lyyi211/acoustic-levitator/hardware/README.uk.md

# Електроніка

Для двох синхронних каналів було вибрано Arduino Uno, подвійний міст TB6612FNG та інвертор 74HC14. У схемі прийнято живлення логіки 5 В і живлення моста 9 В з обмеженням струму 1 А. Кожен канал живить 36 паралельно з’єднаних передавачів через неіндуктивний резистор 22 Ом, 3 Вт.

| Сигнал | З’єднання |
|---|---|
| D9 / D10 | AIN1 / BIN1 і два входи інвертора |
| Виходи інвертора | AIN2 / BIN2 |
| D8 | STBY із резистором 100 кОм до землі |
| PWMA, PWMB, VCC | 5 В |
| AO1 / AO2 | Верхній масив через R2 |
| BO1 / BO2 | Нижній масив через R3 |
| VM | Живлення 9 В через запобіжник |
| GND | Спільна земля |

У схемі є три блокувальні конденсатори по 100 нФ і накопичувальний конденсатор 470 мкФ. 

Плата HC-SR04 містить передавач, приймач та електроніку імпульсного вимірювання відстані. У масив входять лише передавальні капсулі. Живлення модуля 5 В не визначає допустимої напруги безперервного збудження випаяного передавача.

Для електричного розрахунку було задано ємність одного передавача 2 нФ. 

```math
C_{\mathrm{bank}}=36C_T=72\ \mathrm{nF},\qquad V_{\mathrm{bridge,pp}}=2V_M=18\ \mathrm{V}.
```

Номінальна ідеалізована схема дає 17,983 В від піка до піка на масиві, 201,6 мА середньоквадратичного струму, 775,4 мА пікового струму та 0,895 Вт на резисторі кожного масиву. Дослідження чутливості охоплює 5, 7 і 9 В та множники ємності 0,8, 1,0 і 1,2. 

`Reference` у BOM — позиційне позначення компонента на схемі, а не посилання на джерело чи постачальника. `U1` позначає Arduino Uno, `U2` і `U3` — міст та інвертор, `TX1–TX72` — випромінювачі. `R`, `C`, `F`, `J`, `PS` і `MECH` позначають резистори, конденсатори, запобіжник, роз’єми, джерело живлення та механічні деталі. Quantity — кількість фізичних деталей у рядку.
