lyyi211/acoustic-levitator/tools/README.md

# Software used

OpenSCAD was used for the parametric mechanical structure, Python with NumPy and Matplotlib for acoustic calculations and figures, ngspice for the electrical load model, and Arduino IDE / Arduino CLI for the Uno firmware.
