lyyi211/acoustic-levitator/tools/README.uk.md

# Використане програмне забезпечення

Для параметричної механічної конструкції було використано OpenSCAD, для акустичних розрахунків і графіків — Python із NumPy та Matplotlib, для моделі електричного навантаження — ngspice, для прошивки Uno — Arduino IDE / Arduino CLI.
