lyyi211/acoustic-levitator/hardware/netlist.csv

Net | Pin 1 | Pin 2 | Additional connections | Notes
+5V | U1.5V | U2.VCC | U3.VCC; U2.PWMA; U2.PWMB | Regulated logic supply; local 100 nF decoupling
GND | U1.GND | U2.GND | U3.GND; C4-; power return | Star connection near power input
VM_FUSED | J1.POS | F1.1 |  | 9 V DC input; 1 A current limit
VM | F1.2 | U2.VM | C4+ | Short high-current loop
BANK_A_PWM | U1.D9_OC1A | U2.AIN1 | U3.1A | Hardware Timer1 output
BANK_A_N | U3.1Y | U2.AIN2 |  | Complementary bridge input
BANK_B_PWM | U1.D10_OC1B | U2.BIN1 | U3.2A | Hardware Timer1 output
BANK_B_N | U3.2Y | U2.BIN2 |  | Complementary bridge input
BRIDGE_ENABLE | U1.D8 | U2.STBY | R1.1 | R1.2 connects to GND
BANK_A_P | U2.AO1 | R2.1 |  | 22 Ohm >=3 W series damping
BANK_A_LOAD | R2.2 | J2.1 | TX1-TX36.POS | Upper concave bank; 36 parallel emitters
BANK_A_M | U2.AO2 | J2.2 |  | Upper bank differential terminal
BANK_B_P | U2.BO1 | R3.1 |  | 22 Ohm >=3 W series damping
BANK_B_LOAD | R3.2 | J3.1 | TX37-TX72.POS | Lower concave bank; 36 parallel emitters
BANK_B_M | U2.BO2 | J3.2 |  | Lower bank differential terminal
