lyyi211/acoustic-levitator/mechanical/README.uk.md

# Механічна модель

В OpenSCAD було спроєктовано дві однакові увігнуті чаші та спільну опорну раму. У кожній чаші 36 радіальних гнізд у трьох шестикутних кільцях по 6, 12 і 18 елементів. Для конструкції вибрано передавальні капсулі, випаяні з HC-SR04, а не цілі плати далекомірів чи приймальні капсулі.

| Параметр | Значення в CAD |
|---|---:|
| Діаметр / висота корпусу випромінювача | 16 / 13 мм |
| Діаметр гнізда / глибина посадки | 16,4 / 13 мм |
| Крок між центрами в проєкції | 18 мм |
| Радіус спільного фокуса | 90 мм |
| Зовнішній діаметр чаші / товщина оболонки | 142 / 15 мм |
| Задній отвір для виводів / центральний отвір | 6 / 8 мм |
| Розміри основи | 220 × 158 мм |
| Кріплення | Чотири болти M4 × 20 мм, чотири гайки, вісім шайб |

Розміри корпусів отримано з приблизних вимірів наявних деталей. Гніздо має діаметральний зазор 0,4 мм і задній посадковий уступ. Чаші спрямовані всередину; кожне монтажне вушко спирається на полицю рами. Основа, стійки й полиці утворюють суцільну деталь.

Центри робочих поверхонь лежать на сфері навколо спільного фокуса. Уявні полюси розділяє 180 мм; у самих полюсах випромінювачів немає. Відстань між найближчими протилежними центрами робочих поверхонь — 144 мм. Це геометричні відстані, а не задана умова резонансу порожнини.

CAD містить окремі моделі чаші та рами, вигляд збірки й зразок гнізда. `design.json` задає спільні розміри для CAD та акустичної моделі. Аналіз сітки описує зв’язність, замкненість поверхні, орієнтацію граней і топологію отворів.
