lyyi211/acoustic-levitator/simulation/README.uk.md

# Чисельна модель

Усі 72 джерела було змодельовано як орієнтовані поршневі випромінювачі в екрані та розраховано тиск, потенціал Горькова, радіаційну силу й локальну жорсткість у трьох вимірах. Геометрія використовує ті самі параметри, що й конструкція OpenSCAD. Прийнятий активний радіус поршня — 6 мм, зовнішній радіус корпусу — 8 мм.

Опорний піковий тиск у синфазному фокусі становить 1,5 кПа. Він один раз задає амплітуду джерел; порівняння фаз, частот і геометрії зберігають цю амплітуду. Вона не розраховується з напруги моста 9 В. Частинка в моделі — сфера радіусом 0,30 мм, густиною 30 кг/м³ і стисливістю 2,5 × 10⁻¹⁰ Па⁻¹.

Вертикальний пошук охоплює ділянку від −62 до +62 мм. Він знаходить 18 осьово стійких рівноваг, із яких 15 також мають додатну жорсткість у всіх трьох напрямках. Це положення окремої частинки. Одночасне заповнення та розсіювання між частинками не моделюються. Маса однієї частинки — 3,393 мкг; заповнення всіх 15 положень дало б сумарно 50,894 мкг у наближенні незалежних частинок.

Пошук використовує сітку 0,10 мм, поділ інтервалів зі зміною знака сили навпіл і скінченні різниці з кроком 20 мкм. Другий розрахунок із сіткою 0,05 мм та різницями 10 мкм оцінює чутливість результату. Модель поля не враховує відбиття, термов’язкі ефекти, акустичні течії, відмінності джерел і нелінійне поширення. Повне виведення, графіки та пояснення зібрано в розділі фізики, доступному безпосередньо з головного README.
