lyyi211/acoustic-levitator/results/socket_fit_coupon.stl

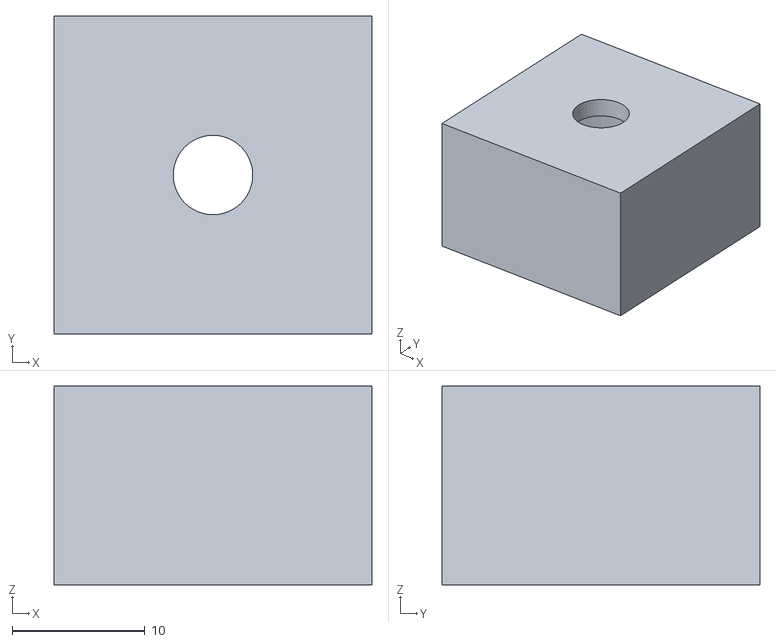
[picture p9: CAD file, 2026-10-31]
results/socket_fit_coupon.stl
24.0 x 24.0 x 15.0
