lyyi211/acoustic-levitator/results/concave_cup.stl

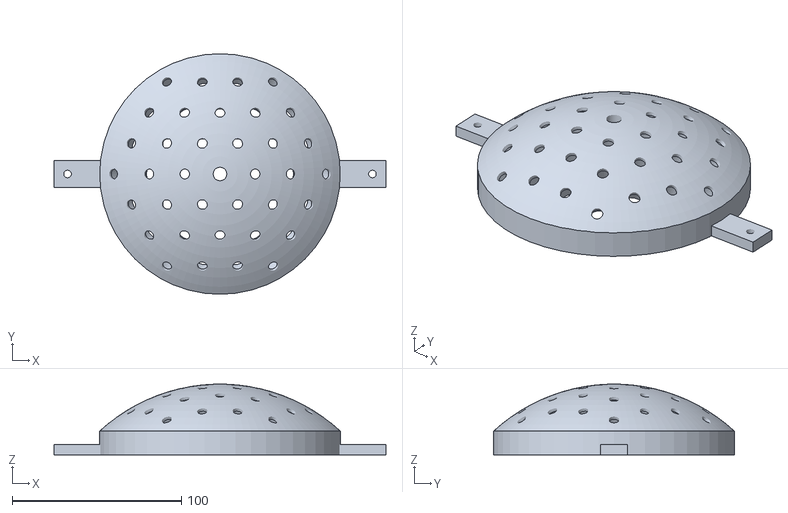
[picture p10: CAD file, 2026-10-31]
results/concave_cup.stl
196.0 x 142.0 x 41.6
