lyyi211/acoustic-levitator/results/levitator_frame.stl

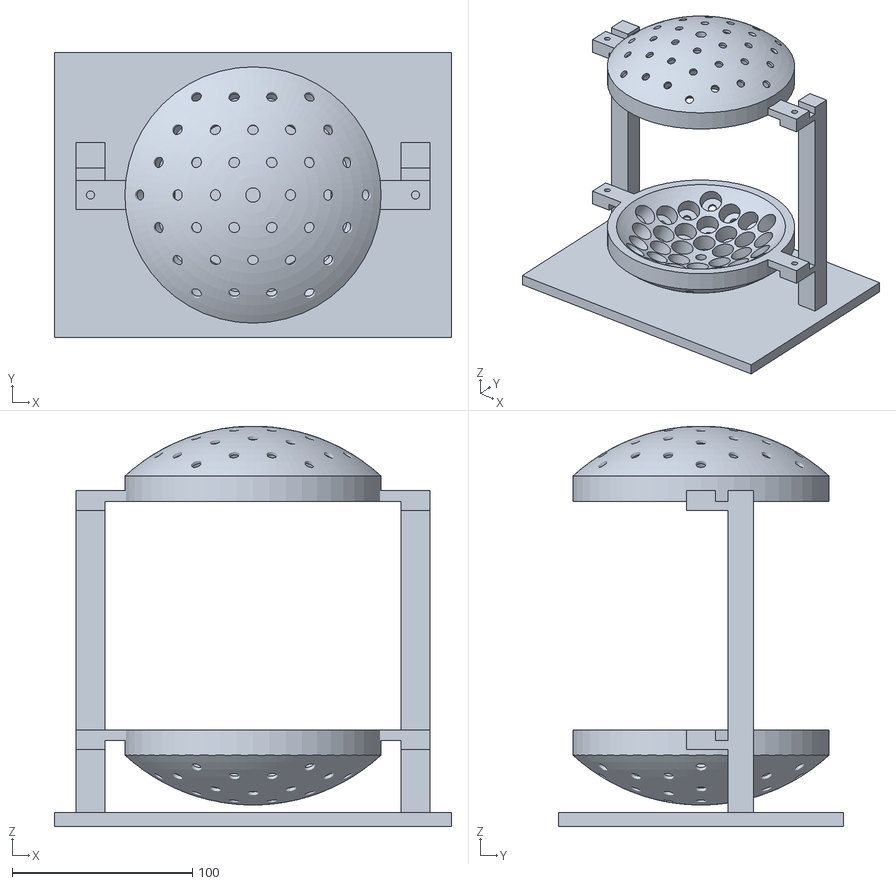
[picture p11: CAD file, 2026-10-31]
results/levitator_frame.stl
220.0 x 158.0 x 221.9
