lyyi211/acoustic-levitator/results/support_frame.stl

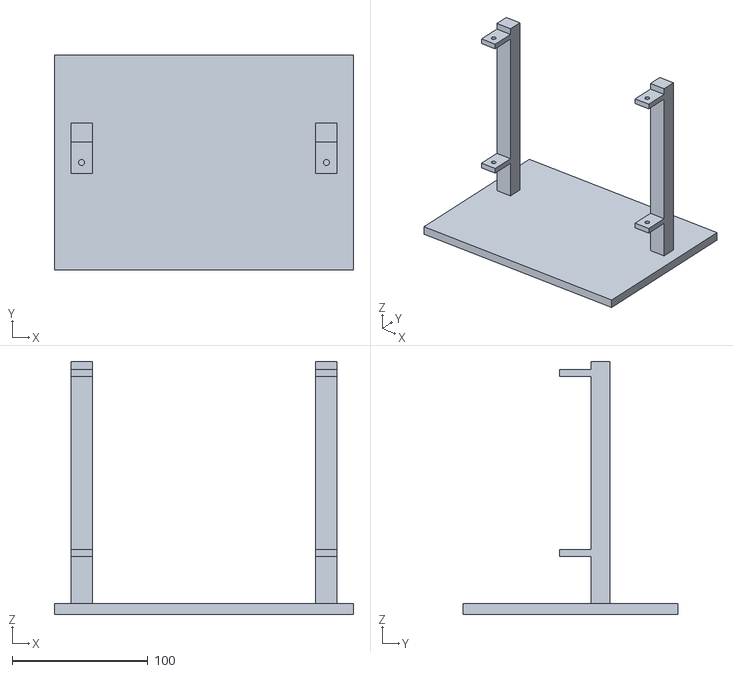
[picture p12: CAD file, 2026-10-31]
results/support_frame.stl
220.0 x 158.0 x 186.3
