lyyi211/acoustic-levitator/mechanical/generated_geometry.scad

// Generated by simulation/array_geometry.py; edit design.json instead.
curvature_radius_mm = 90;
hex_pitch_mm = 18;
hex_rings = 3;
transducer_diameter_mm = 16;
socket_clearance_mm = 0.4;
transducer_body_height_mm = 13;
shell_thickness_mm = 15;
rear_wire_clearance_mm = 6;
cap_inner_aperture_radius_mm = 64;
cup_outer_radius_mm = 71;
center_access_diameter_mm = 8;
ear_thickness_mm = 6;
ear_half_width_mm = 8;
mount_x_mm = 90;
bolt_clearance_mm = 4.5;
post_depth_mm = 14;
post_y_mm = 22;
shelf_thickness_mm = 5;
base_width_mm = 220;
base_depth_mm = 158;
base_thickness_mm = 8;
base_clearance_mm = 4;
frequency_hz = 40000;
emitter_capacitance_pf = 2000;
bridge_supply_v = 9;
series_resistance_ohm = 22;
assumed_piston_radius_mm = 6;
assumed_focus_peak_pa = 1500;
pressure_reference_distance_mm = 100;
rim_z_mm = 63.2771680782;
base_top_mm = -109;
base_bottom_mm = -117;
lower_seat_z_mm = -69.2771680782;
upper_seat_z_mm = 63.2771680782;
upper_face_centres_mm = [
  [-54, 0, 72],
  [-45, 15.5884572681, 76.3675323681],
  [-36, 31.1769145362, 76.3675323681],
  [-27, 46.7653718044, 72],
  [-45, -15.5884572681, 76.3675323681],
  [-36, 0, 82.4863625092],
  [-27, 15.5884572681, 84.4274836768],
  [-18, 31.1769145362, 82.4863625092],
  [-9, 46.7653718044, 76.3675323681],
  [-36, -31.1769145362, 76.3675323681],
  [-27, -15.5884572681, 84.4274836768],
  [-18, 0, 88.1816307402],
  [-9, 15.5884572681, 88.1816307402],
  [0, 31.1769145362, 84.4274836768],
  [9, 46.7653718044, 76.3675323681],
  [-27, -46.7653718044, 72],
  [-18, -31.1769145362, 82.4863625092],
  [-9, -15.5884572681, 88.1816307402],
  [9, 15.5884572681, 88.1816307402],
  [18, 31.1769145362, 82.4863625092],
  [27, 46.7653718044, 72],
  [-9, -46.7653718044, 76.3675323681],
  [0, -31.1769145362, 84.4274836768],
  [9, -15.5884572681, 88.1816307402],
  [18, 0, 88.1816307402],
  [27, 15.5884572681, 84.4274836768],
  [36, 31.1769145362, 76.3675323681],
  [9, -46.7653718044, 76.3675323681],
  [18, -31.1769145362, 82.4863625092],
  [27, -15.5884572681, 84.4274836768],
  [36, 0, 82.4863625092],
  [45, 15.5884572681, 76.3675323681],
  [27, -46.7653718044, 72],
  [36, -31.1769145362, 76.3675323681],
  [45, -15.5884572681, 76.3675323681],
  [54, 0, 72],
];
