lyyi211/acoustic-levitator/results/view_export.scad

// View the exported mesh alongside the editable mechanical source.
import("levitator_frame.stl");
