lyyi211/acoustic-levitator/results/README.uk.md

# Результати розрахунків

У цій папці зібрано механічні моделі, акустичні графіки та чисельні таблиці для випромінювачів 16 × 13 мм. Розділ фізики містить зображення з поясненнями; прямі посилання на всі групи файлів зібрано в головному README.

Механічні файли описують дві чаші, спільну раму, збірку та зразок гнізда. `mesh_validation.json` містить властивості сіток. `array_geometry.csv` задає центри й нормалі 72 робочих поверхонь, а `model_summary.csv` — рівноваги на 38, 40 і 42 кГц. `axial_traps.csv` містить кожну осьово стійку рівновагу в дослідженому інтервалі та три власні значення її жорсткості. `capacity_summary.json` зберігає масу частинки, кількість положень і межі застосування моделі.

`simulation_metadata.json` містить припущення. `driver_waveforms.csv` — таблиця з пробільними роздільниками: час, напруга моста, напруга масиву, струм і потужність резистора. `driver_sweep.csv` містить дев’ять сценаріїв електричної чутливості.
