lyyi211/acoustic-levitator/results/array_geometry.csv

bank | element | x_mm | y_mm | z_mm | nx | ny | nz
upper | 1 | -54.00000000000001 | 0.0 | 72.0 | 0.6000000000000001 | -0.0 | -0.7999999999999999
upper | 2 | -45.00000000000001 | 15.588457268119896 | 76.36753236814712 | 0.5000000000000001 | -0.17320508075688773 | -0.848528137423857
upper | 3 | -36.00000000000001 | 31.176914536239792 | 76.36753236814712 | 0.4000000000000001 | -0.34641016151377546 | -0.848528137423857
upper | 4 | -27.000000000000004 | 46.76537180435969 | 72.0 | 0.30000000000000004 | -0.5196152422706632 | -0.7999999999999999
upper | 5 | -45.00000000000001 | -15.588457268119896 | 76.36753236814712 | 0.5000000000000001 | 0.17320508075688773 | -0.848528137423857
upper | 6 | -36.00000000000001 | 0.0 | 82.48636250920512 | 0.4000000000000001 | -0.0 | -0.916515138991168
upper | 7 | -27.000000000000004 | 15.588457268119896 | 84.42748367682172 | 0.30000000000000004 | -0.17320508075688773 | -0.9380831519646858
upper | 8 | -18.000000000000004 | 31.176914536239792 | 82.48636250920512 | 0.20000000000000004 | -0.34641016151377546 | -0.916515138991168
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
