lyyi211/acoustic-levitator/results/axial_traps.csv

z_m | K1_N_per_m | K2_N_per_m | K3_N_per_m | stable_3d | residual_force_N
-0.039677996788918965 | 3.8109598494231963e-06 | 3.8109598573315545e-06 | 5.444547475140875e-05 | True | 3.5015670203156874e-17
-0.03470935393720864 | 3.170006207659804e-06 | 3.1700062086731356e-06 | 7.493835035776227e-05 | True | 1.4981106915038845e-17
-0.030440448923408983 | -5.786958120129833e-06 | -5.786958112732257e-06 | 4.3627215809627975e-05 | False | 2.6112405335736926e-17
-0.02664662252813577 | 8.746844813905172e-07 | 8.74684507700526e-07 | 4.613671963533076e-05 | True | 3.498668945138881e-18
-0.02175730469077825 | 1.1423531913955067e-05 | 1.1423531954701224e-05 | 0.0002049696468058302 | True | 2.337198139968564e-16
-0.01690309746116399 | 2.4505007537030323e-05 | 2.4505007545980903e-05 | 0.0003934615885284843 | True | 1.6271604838752655e-16
-0.012069139866530893 | 3.753305648596586e-05 | 3.7533056536538595e-05 | 0.0005761203449597663 | True | 2.1312639364863138e-16
-0.007250219099223608 | 4.781060657571348e-05 | 4.781060660677053e-05 | 0.0007191181018015827 | True | 1.417534789412887e-16
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
