lyyi211/acoustic-levitator/results/driver_sweep.csv

bridge_supply_V | capacitance_scale | bank_capacitance_F | vdiff_pp | vbank_pp | irms | ipeak | resistor_power
5.0 | 0.8 | 5.76e-08 | 9.99997 | 9.998656 | 0.0999947 | 0.4276812 | 0.2200687
5.0 | 1.0 | 7.2e-08 | 9.999796 | 9.990817 | 0.112019 | 0.4307927 | 0.2761404
5.0 | 1.2 | 8.639999999999999e-08 | 9.999266 | 9.966975 | 0.12276 | 0.4324908 | 0.3316053
7.0 | 0.8 | 5.76e-08 | 13.99996 | 13.99812 | 0.139993 | 0.5987536 | 0.4313346
7.0 | 1.0 | 7.2e-08 | 13.99971 | 13.98714 | 0.156827 | 0.6031098 | 0.5412352
7.0 | 1.2 | 8.639999999999999e-08 | 13.99897 | 13.95376 | 0.171864 | 0.6054872 | 0.6499463
9.0 | 0.8 | 5.76e-08 | 17.99995 | 17.99758 | 0.17999 | 0.7698261 | 0.7130225
9.0 | 1.0 | 7.2e-08 | 17.99963 | 17.98347 | 0.201635 | 0.7754269 | 0.894695
9.0 | 1.2 | 8.639999999999999e-08 | 17.99868 | 17.94055 | 0.220968 | 0.7784835 | 1.074401
