lyyi211/acoustic-levitator/results/driver_waveforms.csv

 time            vdiff           vbank           i(VSENSE)       pdamp
 0.00000000e+00 -9.00000000e+00 -9.00000000e+00  0.00000000e+00  0.00000000e+00
 5.00000000e-10 -8.91199938e+00 -8.99997223e+00  3.99876581e-03  3.51782817e-04
 1.00000000e-09 -8.82399815e+00 -8.99991670e+00  7.99629782e-03  1.40669713e-03
 2.00000000e-09 -8.64799445e+00 -8.99975014e+00  1.59888950e-02  5.62418478e-03
 4.00000000e-09 -8.29597965e+00 -8.99908419e+00  3.19592973e-02  2.24707271e-02
 8.00000000e-09 -7.59192051e+00 -8.99642307e+00  6.38410253e-02  8.96648833e-02
 1.60000000e-08 -6.18368445e+00 -8.98580030e+00  1.27368902e-01  3.56902419e-01
 3.20000000e-08 -3.36674406e+00 -8.94348285e+00  2.53488127e-01  1.41363707e+00
 6.40000000e-08  2.26898687e+00 -8.77559076e+00  5.02026256e-01  5.54466796e+00
 1.00000000e-07  8.61208606e+00 -8.45612723e+00  7.75827877e-01  1.32419957e+01
 1.05000000e-07  8.61327964e+00 -8.40241607e+00  7.73440714e-01  1.31606318e+01
 1.15000000e-07  8.61565946e+00 -8.29532428e+00  7.68681079e-01  1.29991532e+01
 1.35000000e-07  8.62037530e+00 -8.08311171e+00  7.59249409e-01  1.26821126e+01
 1.75000000e-07  8.62963443e+00 -7.66645045e+00  7.40731131e-01  1.20710174e+01
 2.25000000e-07  8.64089175e+00 -7.15987141e+00  7.18216507e-01  1.13483689e+01
 2.75000000e-07  8.65180689e+00 -6.66868991e+00  6.96386218e-01  1.06689828e+01
 3.25000000e-07  8.66239027e+00 -6.19243793e+00  6.75219464e-01  1.00302691e+01
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
 7.27750000e-05 -8.99927464e+00 -8.96735887e+00 -1.45071684e-03  4.63007456e-05
 7.28250000e-05 -8.99929669e+00 -8.96835100e+00 -1.40662210e-03  4.35288862e-05
 7.28750000e-05 -8.99931807e+00 -8.96931298e+00 -1.36386763e-03  4.09229681e-05
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
