lyyi211/acoustic-levitator/results/model_summary.csv

frequency_Hz | wavelength_m | ka | equilibrium_z_m | Fx_N | Fy_N | Fz_N | effective_weight_N | stiffness_eigenvalue_1_N_per_m | stiffness_eigenvalue_2_N_per_m | stiffness_eigenvalue_3_N_per_m | locally_stable_3d
38000.0 | 0.00903157894736842 | 0.2087072042594618 | 0.0024836224985122692 | 1.0339757656912844e-20 | -2.067951531382569e-20 | 3.193770407517258e-08 | 3.193770504693072e-08 | 4.774045706144392e-05 | 4.774045706356054e-05 | 0.0007205525474273352 | True
40000.0 | 0.008579999999999999 | 0.21969179395732819 | 0.002361514134407044 | -1.2924697071141056e-20 | 2.584939414228211e-21 | 3.193770343357253e-08 | 3.193770504693072e-08 | 5.290278577231027e-05 | 5.290278583776131e-05 | 0.0007984327733394646 | True
42000.0 | 0.00817142857142857 | 0.23067638365519455 | 0.002250848164558411 | 3.618915179919496e-20 | -3.360421238496675e-20 | 3.193770295841155e-08 | 3.193770504693072e-08 | 5.833009533039717e-05 | 5.8330095366328264e-05 | 0.0008802910207655623 | True
